Acathla-fr/BlueSCSI-v2/hardware/DB25_External/Pictures/DB25_External_front.png

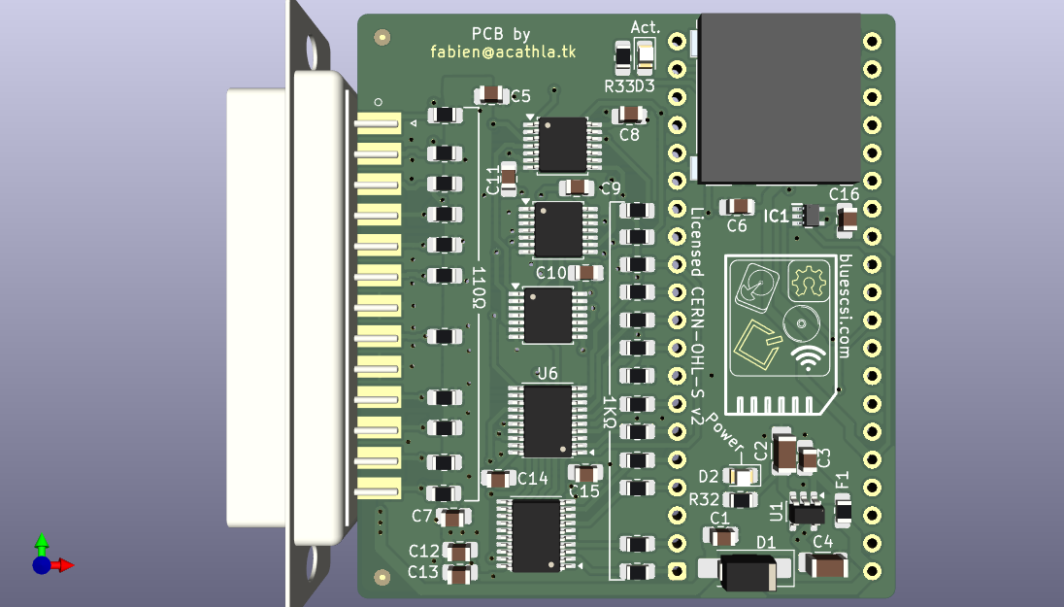
hardware/DB25_External/Pictures/DB25_External_front.png
