Acathla-fr/BlueSCSI-v2/hardware/DB25_External/DB25_External.kicad_pcb

## KiCad design hardware/DB25_External/DB25_External.kicad_pcb (2026-02-06)

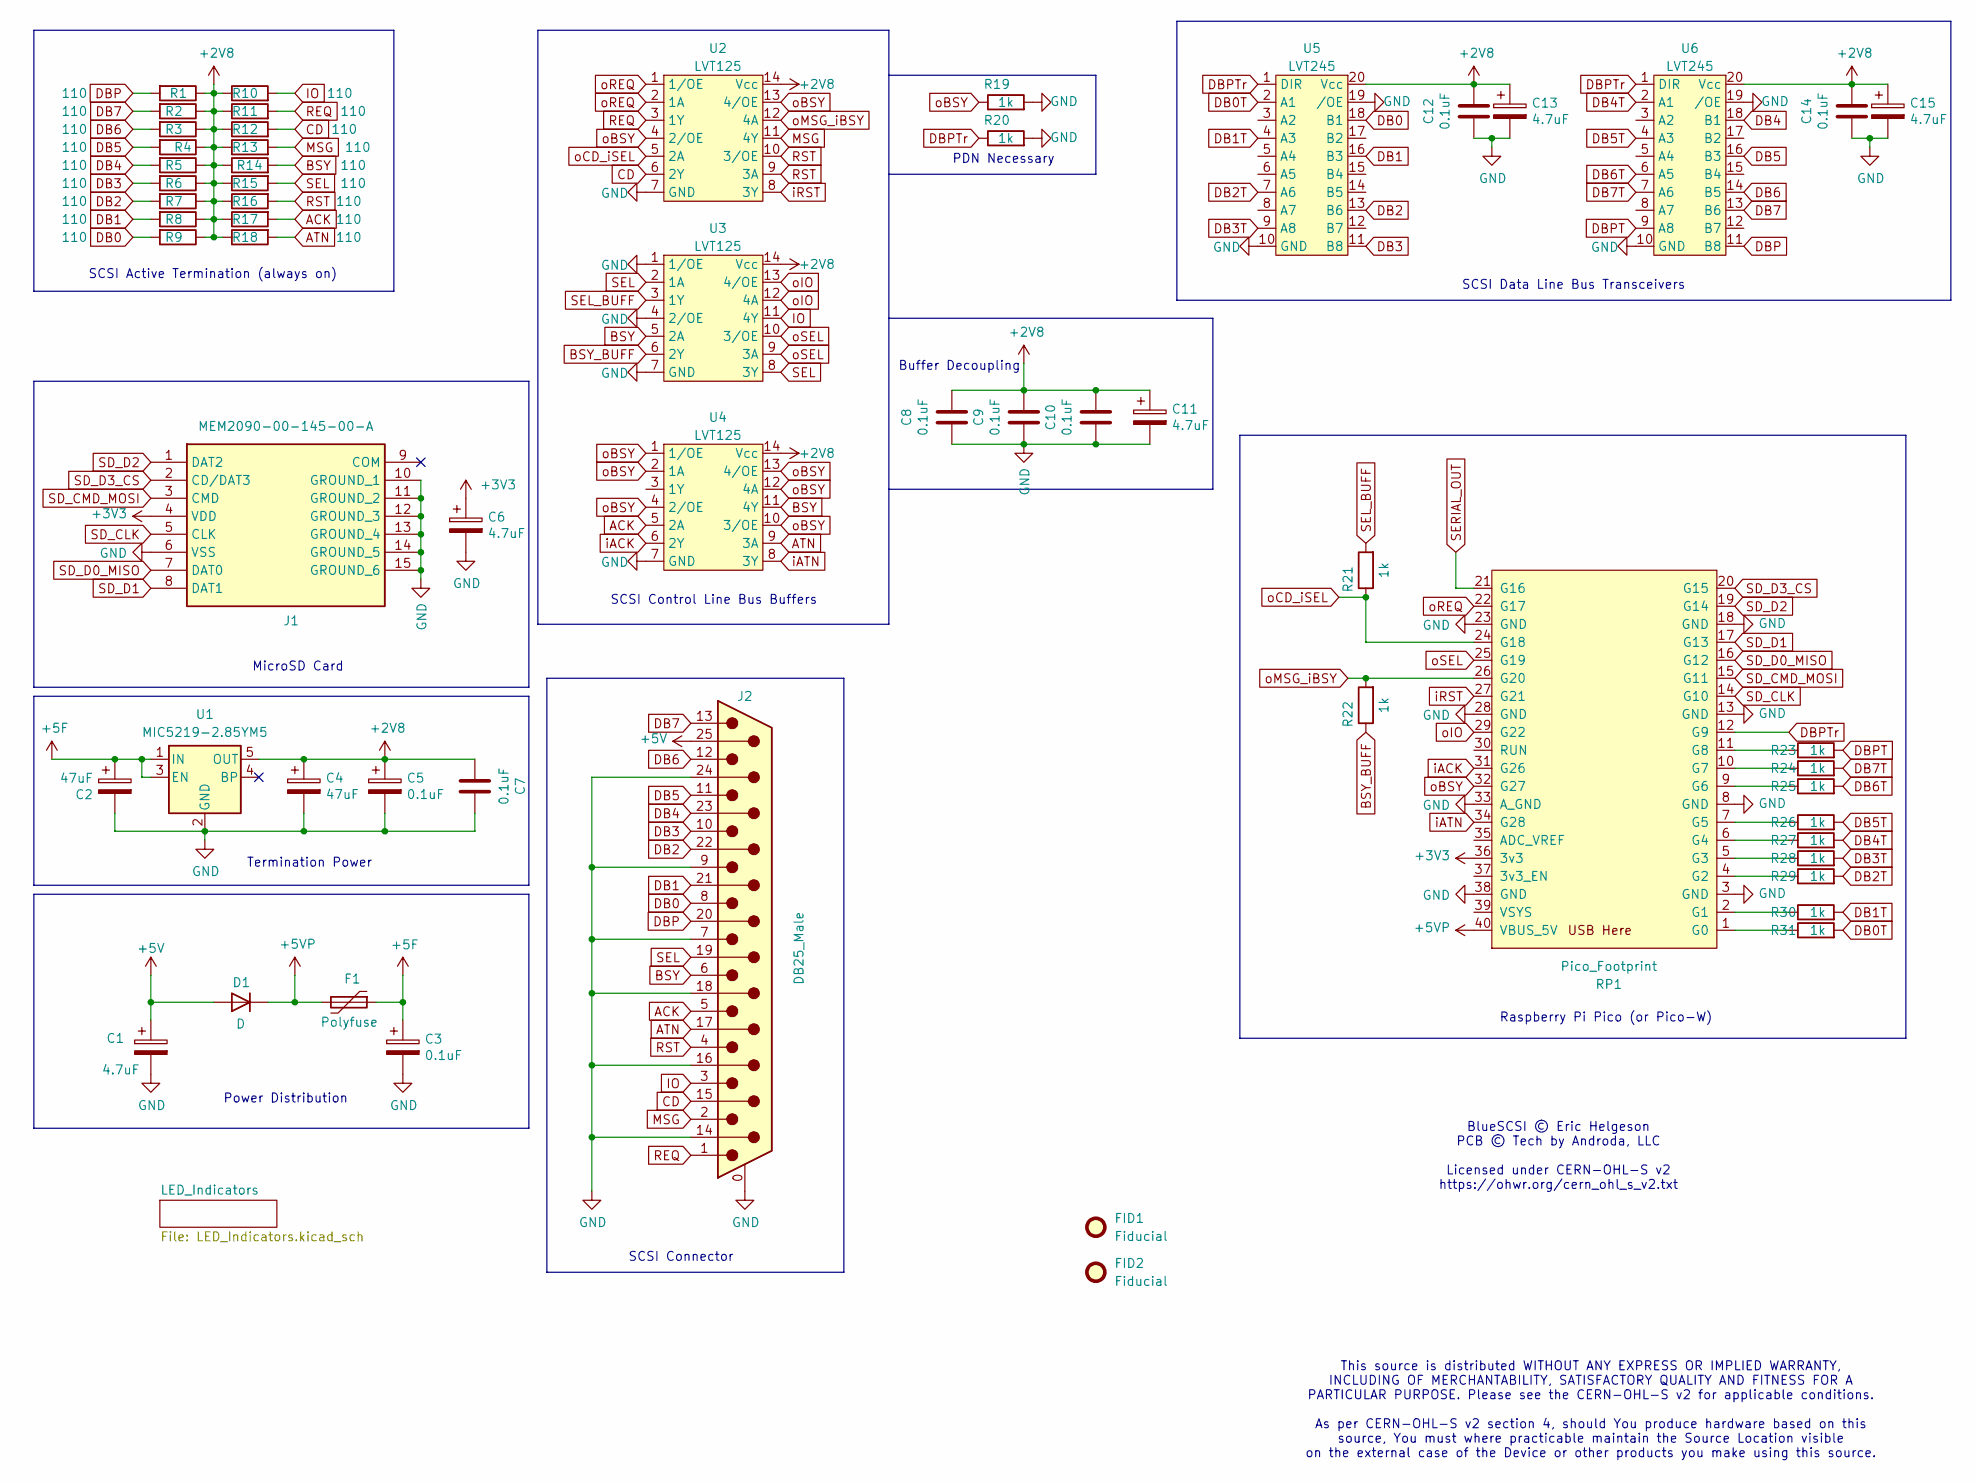
[picture p4: schematic DB25_External.kicad_sch, Forked from BlueSCSI V2, DB25 External 2024.01a]

Parts:
C1, C6, C11, C13, C15: 4.7uF; C_0805_2012Metric_Pad1.18x1.45mm_HandSolder
C2, C4: 47uF; C_1206_3216Metric_Pad1.33x1.80mm_HandSolder
C3, C5, C7, C8, C9, C10, C12, C14: 0.1uF; C_0805_2012Metric_Pad1.18x1.45mm_HandSolder
D1: D; D_SMA_Handsoldering
F1: Polyfuse; Fuse_0805_2012Metric_Pad1.15x1.40mm_HandSolder
FID1, FID2: Fiducial; Fiducial_0.5mm_Mask1.5mm
J1: MEM2090-00-145-00-A; MEM20900014500A; Manufacturer_Part_Number MEM2090-00-145-00-A; Mouser Part Number 640-MEM20900014500A
J2: DB25_Male; DSUB-25_Male_Horizontal_middle_mount
R1, R2, R3, R4, R5, R6, R7, R8, R9, R10, R11, R12, R13, R14, R15, R16, R17, R18: 110; R_0805_2012Metric_Pad1.20x1.40mm_HandSolder
R19, R20, R21, R22, R23, R24, R25, R26, R27, R28, R29, R30, R31: 1k; R_0805_2012Metric_Pad1.20x1.40mm_HandSolder
RP1: Pico_Footprint; BluePillModule
U1: MIC5219-2.85YM5; SOT-23-5
U2, U3, U4: LVT125; TSSOP-14_4.4x5mm_P0.65mm
U5, U6: LVT245; TSSOP-20_4.4x6.5mm_P0.65mm

Connections:
+2V8: C4.1, C5.1, C7.1, C8.2, C9.2, C10.2, C11.1, C12.1, C13.1, C14.1, C15.1, R1.1, R2.1, R3.1, R4.1, R5.1, R6.1, R7.1, R8.1, R9.1, R10.1, R11.1, R12.1, R13.1, R14.1, R15.1, R16.1, R17.1, R18.1, U1.5 (OUT), U2.14 (Vcc), U3.14 (Vcc), U4.14 (Vcc), U5.20 (Vcc), U6.20 (Vcc)
+3V3: C6.1, J1.4 (VDD), RP1.36 (3v3); also elsewhere on the board
+5F: C2.1, C3.1, F1.1, U1.1 (IN), U1.3 (EN); also elsewhere on the board
+5V: C1.1, D1.2 (A), J2.25
+5VP: D1.1 (K), F1.2, RP1.40 (VBUS_5V)
ACK: J2.5, R17.2, U4.5 (2A)
ATN: J2.17, R18.2, U4.9 (3A)
BSY: J2.6, R14.2, U3.5 (2A), U4.11 (4Y)
BSY_BUFF: R22.1, U3.6 (2Y)
CD: J2.15, R12.2, U2.6 (2Y)
DB0: J2.8, R9.2, U5.18 (B1)
DB0T: R31.2, U5.2 (A1)
DB1: J2.21, R8.2, U5.16 (B3)
DB1T: R30.2, U5.4 (A3)
DB2: J2.22, R7.2, U5.13 (B6)
DB2T: R29.2, U5.7 (A6)
DB3: J2.10, R6.2, U5.11 (B8)
DB3T: R28.2, U5.9 (A8)
DB4: J2.23, R5.2, U6.18 (B1)
DB4T: R27.2, U6.2 (A1)
DB5: J2.11, R4.2, U6.16 (B3)
DB5T: R26.2, U6.4 (A3)
DB6: J2.12, R3.2, U6.14 (B5)
DB6T: R25.2, U6.6 (A5)
DB7: J2.13, R2.2, U6.13 (B6)
DB7T: R24.2, U6.7 (A6)
DBP: J2.20, R1.2, U6.11 (B8)
DBPT: R23.2, U6.9 (A8)
DBPTr: R20.1, RP1.12 (G9), U5.1 (DIR), U6.1 (DIR)
GND: C1.2, C2.2, C3.2, C4.2, C5.2, C6.2, C7.2, C8.1, C9.1, C10.1, C11.2, C12.2, C13.2, C14.2, C15.2, J1.6 (VSS), J1.10 (GROUND_1), J1.11 (GROUND_2), J1.12 (GROUND_3), J1.13 (GROUND_4), J1.14 (GROUND_5), J1.15 (GROUND_6), J2.0 (PAD), J2.7, J2.9, J2.14, J2.16, J2.18, J2.24, R19.2, R20.2, RP1.3 (GND), RP1.8 (GND), RP1.13 (GND), RP1.18 (GND), RP1.23 (GND), RP1.28 (GND), RP1.33 (A_GND), RP1.38 (GND), U1.2 (GND), U2.7 (GND), U3.1 (1/OE), U3.4 (2/OE), U3.7 (GND), U4.7 (GND), U5.10 (GND), U5.19 (/OE), U6.10 (GND), U6.19 (/OE); also elsewhere on the board
IO: J2.3, R10.2, U3.11 (4Y)
MSG: J2.2, R13.2, U2.11 (4Y)
unnamed: R31.1, RP1.1 (G0)
unnamed: R30.1, RP1.2 (G1)
unnamed: R29.1, RP1.4 (G2)
unnamed: R28.1, RP1.5 (G3)
unnamed: R27.1, RP1.6 (G4)
unnamed: R26.1, RP1.7 (G5)
unnamed: R25.1, RP1.9 (G6)
unnamed: R24.1, RP1.10 (G7)
unnamed: R23.1, RP1.11 (G8)
REQ: J2.1, R11.2, U2.3 (1Y)
RST: J2.4, R16.2, U2.9 (3A), U2.10 (3/OE)
SD_CLK: J1.5 (CLK), RP1.14 (G10)
SD_CMD_MOSI: J1.3 (CMD), RP1.15 (G11)
SD_D0_MISO: J1.7 (DAT0), RP1.16 (G12)
SD_D1: J1.8 (DAT1), RP1.17 (G13)
SD_D2: J1.1 (DAT2), RP1.19 (G14)
SD_D3_CS: J1.2 (CD/DAT3), RP1.20 (G15)
SEL: J2.19, R15.2, U3.2 (1A), U3.8 (3Y)
SEL_BUFF: R21.2, U3.3 (1Y)
SERIAL_OUT: RP1.21 (G16)
iACK: RP1.31 (G26), U4.6 (2Y)
iATN: RP1.34 (G28), U4.8 (3Y)
iRST: RP1.27 (G21), U2.8 (3Y)
oBSY: R19.1, RP1.32 (G27), U2.4 (2/OE), U2.13 (4/OE), U4.1 (1/OE), U4.2 (1A), U4.4 (2/OE), U4.10 (3/OE), U4.12 (4A), U4.13 (4/OE); also elsewhere on the board
oCD_iSEL: R21.1, RP1.24 (G18), U2.5 (2A)
oIO: RP1.29 (G22), U3.12 (4A), U3.13 (4/OE)
oMSG_iBSY: R22.2, RP1.26 (G20), U2.12 (4A)
oREQ: RP1.22 (G17), U2.1 (1/OE), U2.2 (1A)
oSEL: RP1.25 (G19), U3.9 (3A), U3.10 (3/OE)

Notes on the sheet:
Termination Power
Raspberry Pi Pico (or Pico-W)
MicroSD Card
BlueSCSI © Eric Helgeson PCB © Tech by Androda, LLC Licensed under CERN-OHL-S v2 https://ohwr.org/cern_ohl_s_v2.txt
Power Distribution
SCSI Connector
SCSI Data Line Bus Transceivers
SCSI Control Line Bus Buffers
PDN Necessary
This source is distributed WITHOUT ANY EXPRESS OR IMPLIED WARRANTY, INCLUDING OF MERCHANTABILITY, SATISFACTORY QUALITY AND FITNESS FOR A PARTICULAR PURPOSE. Please see the CERN-OHL-S v2 for applicable conditions. As per CERN-OHL-S v2 section 4, should You produce hardware based on this source, You 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
SCSI Active Termination (always on)
Buffer Decoupling

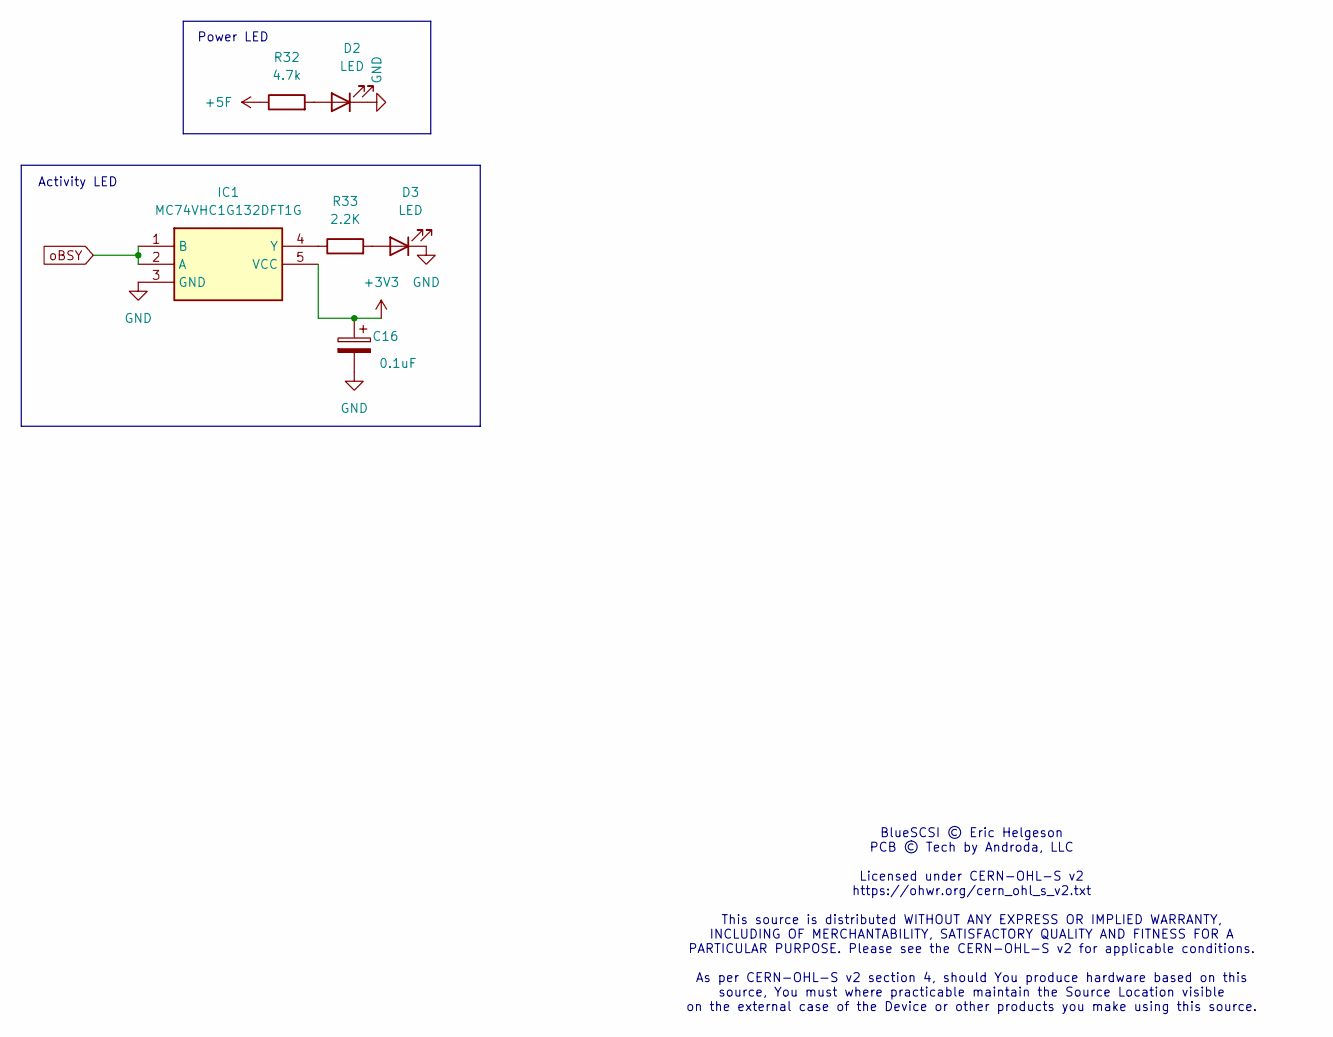
[picture p5: schematic LED_Indicators.kicad_sch, BlueSCSI V2, DB25 External 2024.01a]

Parts:
C16: 0.1uF; C_0805_2012Metric_Pad1.18x1.45mm_HandSolder
D2, D3: LED; LED_0805_2012Metric_Pad1.15x1.40mm_HandSolder
IC1: MC74VHC1G132DFT1G; SOT65P210X110-5N; Manufacturer_Part_Number MC74VHC1G132DFT1G; Mouser Part Number 863-C74VHC1G132DFT1G
R32: 4.7k; R_0805_2012Metric_Pad1.20x1.40mm_HandSolder
R33: 2.2K; R_0805_2012Metric_Pad1.20x1.40mm_HandSolder

Connections:
+3V3: C16.1, IC1.5 (VCC); also elsewhere on the board
+5F: R32.1; also elsewhere on the board
GND: C16.2, D2.1 (K), D3.1 (K), IC1.3 (GND); also elsewhere on the board
unnamed: D2.2 (A), R32.2
unnamed: D3.2 (A), R33.2
unnamed: IC1.4 (Y), R33.1
oBSY: IC1.1 (B), IC1.2 (A); also elsewhere on the board

Notes on the sheet:
Power LED
BlueSCSI © Eric Helgeson PCB © Tech by Androda, LLC Licensed under CERN-OHL-S v2 https://ohwr.org/cern_ohl_s_v2.txt This source is distributed WITHOUT ANY EXPRESS OR IMPLIED WARRANTY, INCLUDING OF MERCHANTABILITY, SATISFACTORY QUALITY AND FITNESS FOR A PARTICULAR PURPOSE. Please see the CERN-OHL-S 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
Activity LED

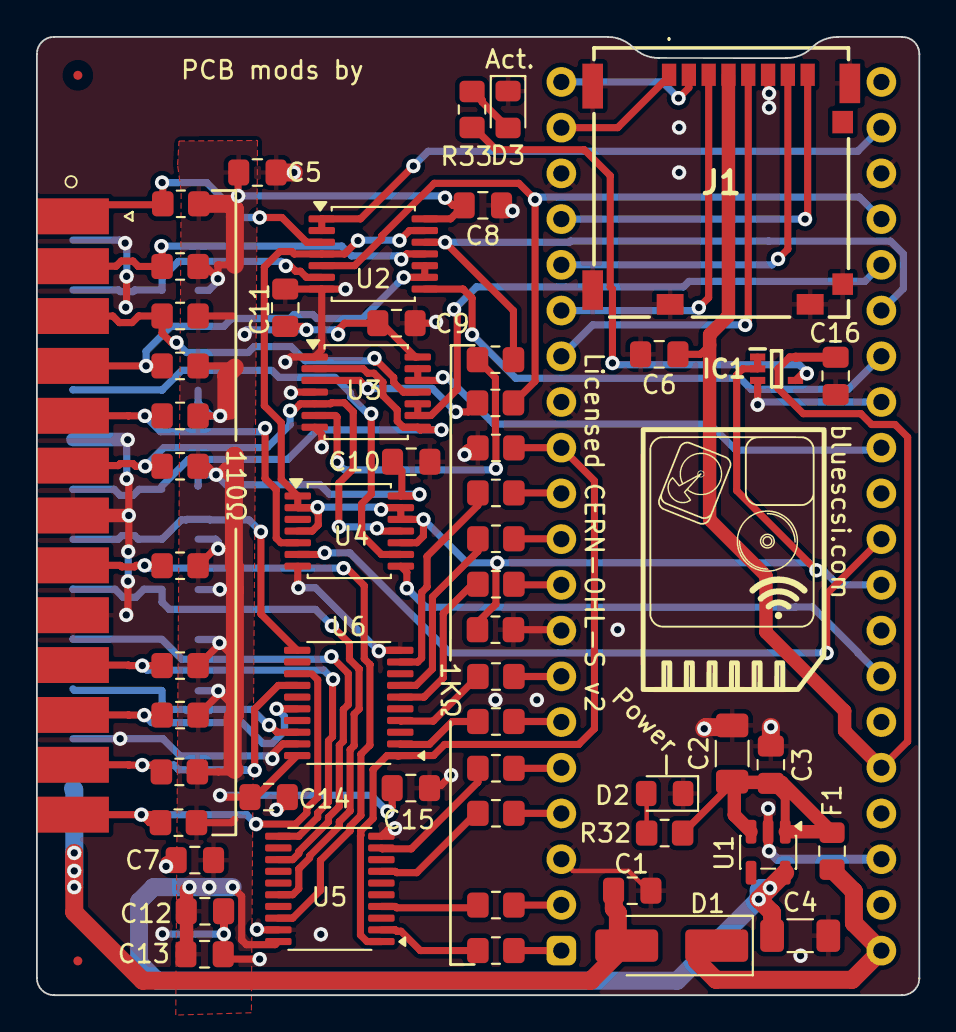
[picture p6: board DB25_External.kicad_pcb from above]

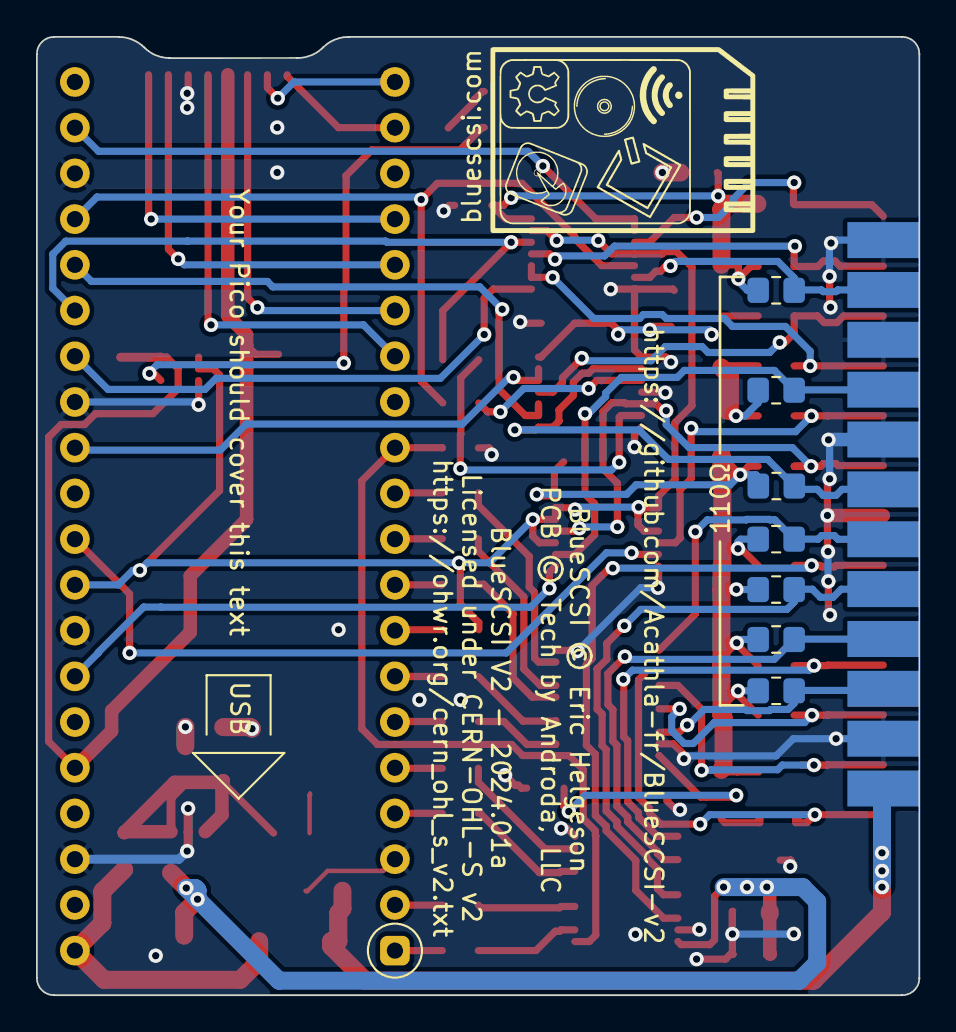
[picture p7: board DB25_External.kicad_pcb from below]

Board: 2 copper layers, 49.0 x 53.2 mm, 65 parts (8 on the bottom side), 63 nets.
