Acathla-fr/BlueSCSI-v2/(commit log)

2026-01-01 My version sent to Aisler, pico under the PCB
    [DB25_External.kicad_pcb, DB25_External.kicad_sch, LED_Indicators.kicad_sch]
2026-02-05 Via moved out of pad and original (c) text added
    [DB25_External.kicad_pcb]
2026-02-06 Clean up
    [CaseBottom.stl, CaseTop.stl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]
