Acathla-fr/BlueSCSI-v2/(notices)

Notices in the files:
hardware/DB25_External/DB25_External.kicad_pcb:
Licensed CERN-OHL-S v2
